UCSCRocketry/avionics-library/Models/E22-400MM22S.step

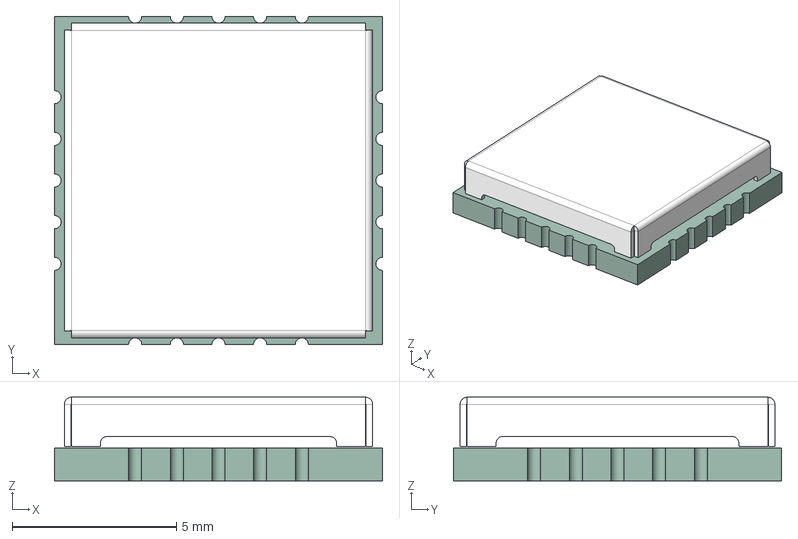
[picture p1: CAD file, 2026-10-04]
Models/E22-400MM22S.step
10.0 x 10.0 x 2.55 mm
PBZ-135
10705-V1.1_PCB
