UCSCRocketry/avionics-library/Models/st11s008v4hr2000.stp

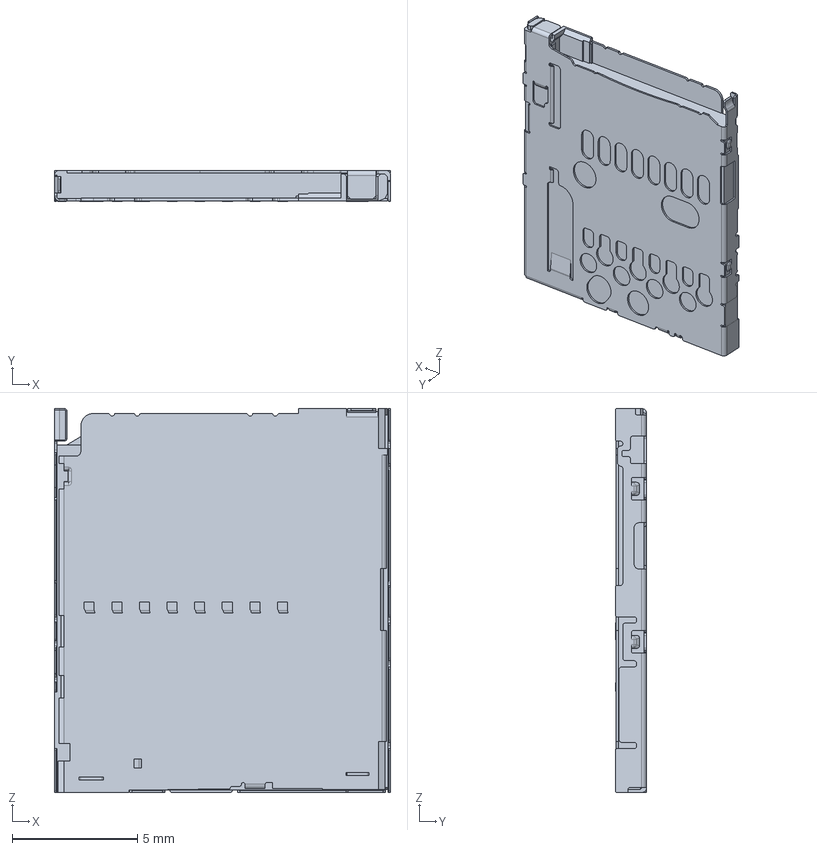
[picture p2: CAD file, 2026-09-12]
Models/st11s008v4hr2000.stp
13.4 x 1.25 x 15.3 mm
