UCSCRocketry/avionics-library/Models/LBAA0QB1SJ-296.step

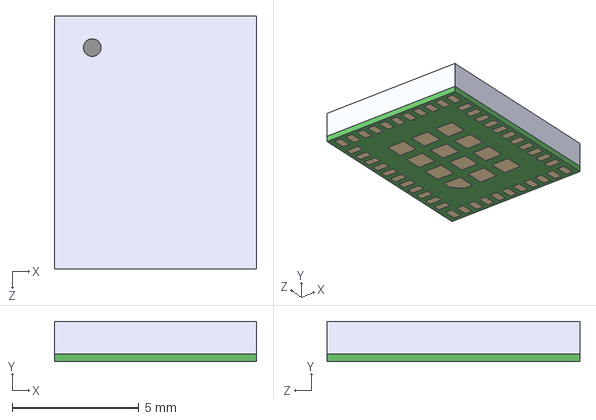
[picture p3: CAD file, 2026-03-16]
Models/LBAA0QB1SJ-296.step
8.00 x 1.60 x 10.0 mm
