UCSCRocketry/avionics-library/Models/SAM-M8Q-0.STEP

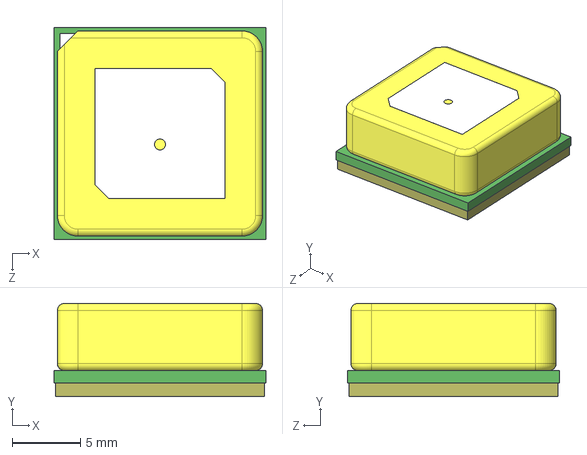
[picture p4: CAD file, 2026-03-16]
Models/SAM-M8Q-0.STEP
15.5 x 6.80 x 15.5 mm
