UCSCRocketry/avionics-library/(commit log)

2025-11-05 Added footprint libf
2025-11-07 update lsm9ds1 footprint
2025-12-05 Added graphic footprints
2026-01-20 Added USB connector
2026-01-30 Added part for radio footprint
2026-01-30 Add MPM3610 Footprint
2026-02-03 Add INA229 Schematic
2026-02-04 Unborked IMU
2026-02-05 Updated IMU
2026-02-05 Added sensor footprints
2026-02-07 KX footprint
2026-02-18 Added fiducial footprint
2026-03-16 Added rf components
    [LBAA0QB1SJ-296.step, SAM-M8Q-0.STEP]
2026-06-20 add mag and accel/gyro symbols and footprints
2026-09-12 Add ST11S008V4HR2000
    [st11s008v4hr2000.stp]
2026-09-23 Pin snapshots to library content commits
2026-10-02 Add PE4259-63 RF switch symbol
2026-10-04 Add E22-400MM22S LoRa module
    [E22-400MM22S.step]
2026-10-05 Add AON7544 power MOSFET
2026-10-05 Add six-position LCKELEC DIP switch
2026-10-05 Add 3D model for Phoenix 1792511
    [1792511.stp]
2026-10-06 Remove Phoenix 1792511 library entry
    [1792511.stp]
2026-10-06 Recover 1x05 0.5 mm pad footprint
2026-10-10 Add ADXL375BCCZ accelerometer
2026-10-10 Add LSM6DSO32TR IMU
2026-10-10 Add LSM6DSOXTR IMU
2026-10-10 Add ISM330DHCXTR industrial IMU
2026-10-10 Add H2UJ4U1H2Q0100 GNSS antenna
2026-10-18 Add MIA-M10Q symbol and footprint
2026-11-04 Add E22 breakout footprint and connect BUSY and INT
